PPML-Group/LiberGripper_V1/README.md

# LiberGripper_V1
A compact, single–degree-of-freedom **parallel gripper** driven by a **DM4310** actuator. **Purpose-built for robotic manipulation and grasping tasks.**  
Two interchangeable end-effector variants are provided:

- **Finned adaptive fingers** — compliant, underactuated “fin-ray” style fingers that conform to objects of varying shapes.
- **Rigid parallel fingers** — simple, stiff pads for precise, repeatable clamping.

<!-- ![Finned adaptive gripper](Picture/LiberGripper_Fin-ray.png)
![Rigid parallel gripper](Picture/LiberGripper_normal.png) -->
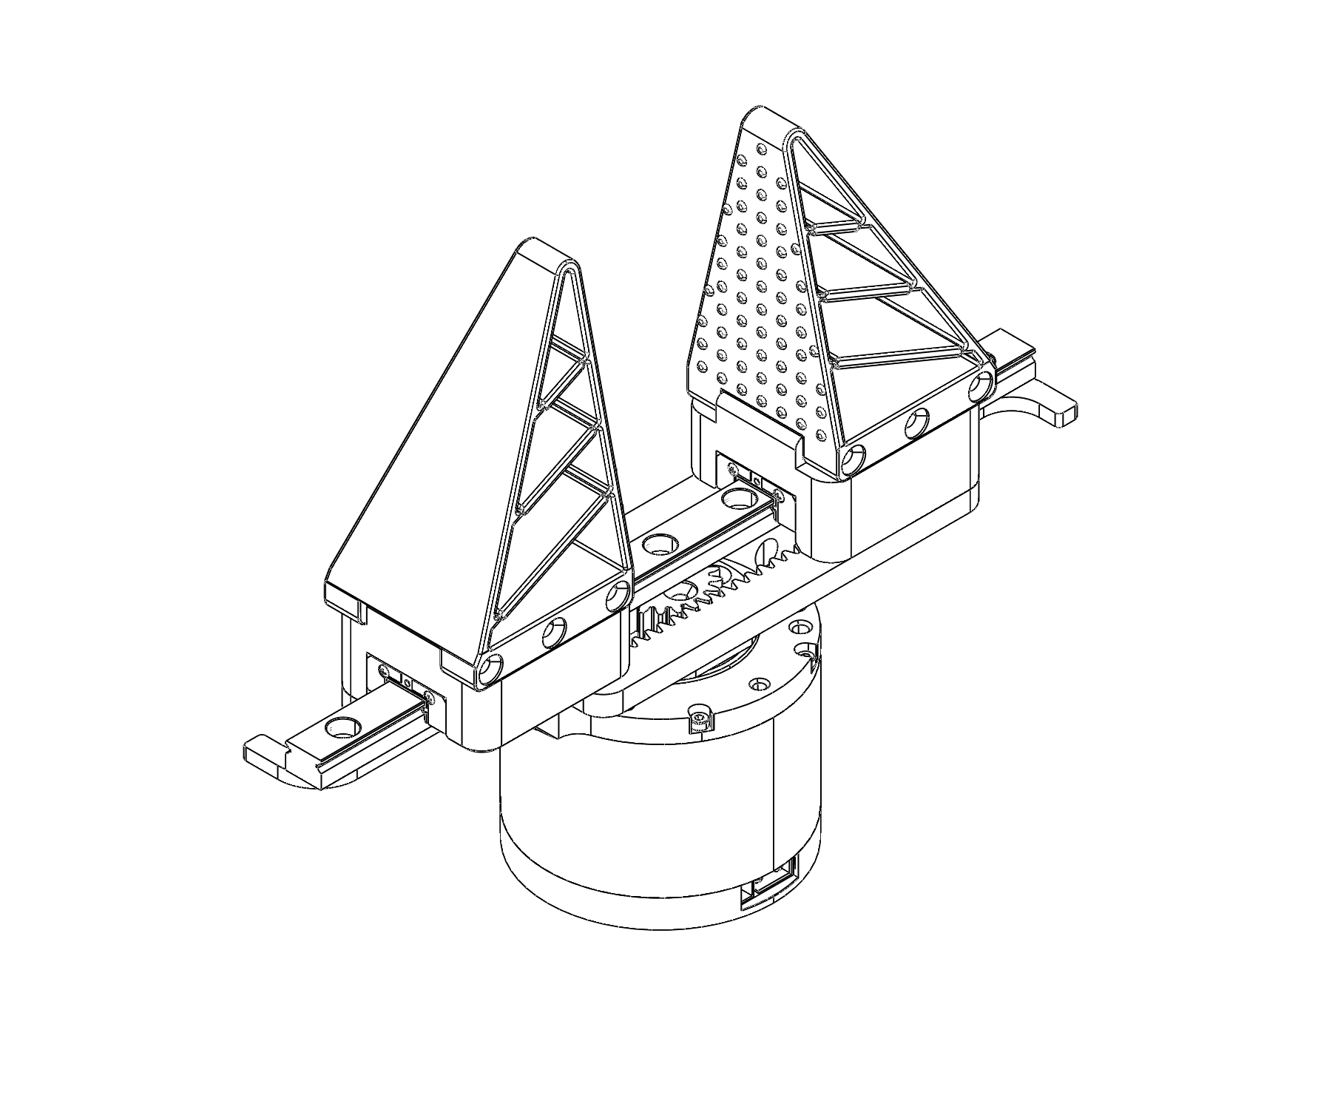
[picture p1: Picture/LiberGripper_Fin-ray.png]
Finned adaptive gripper

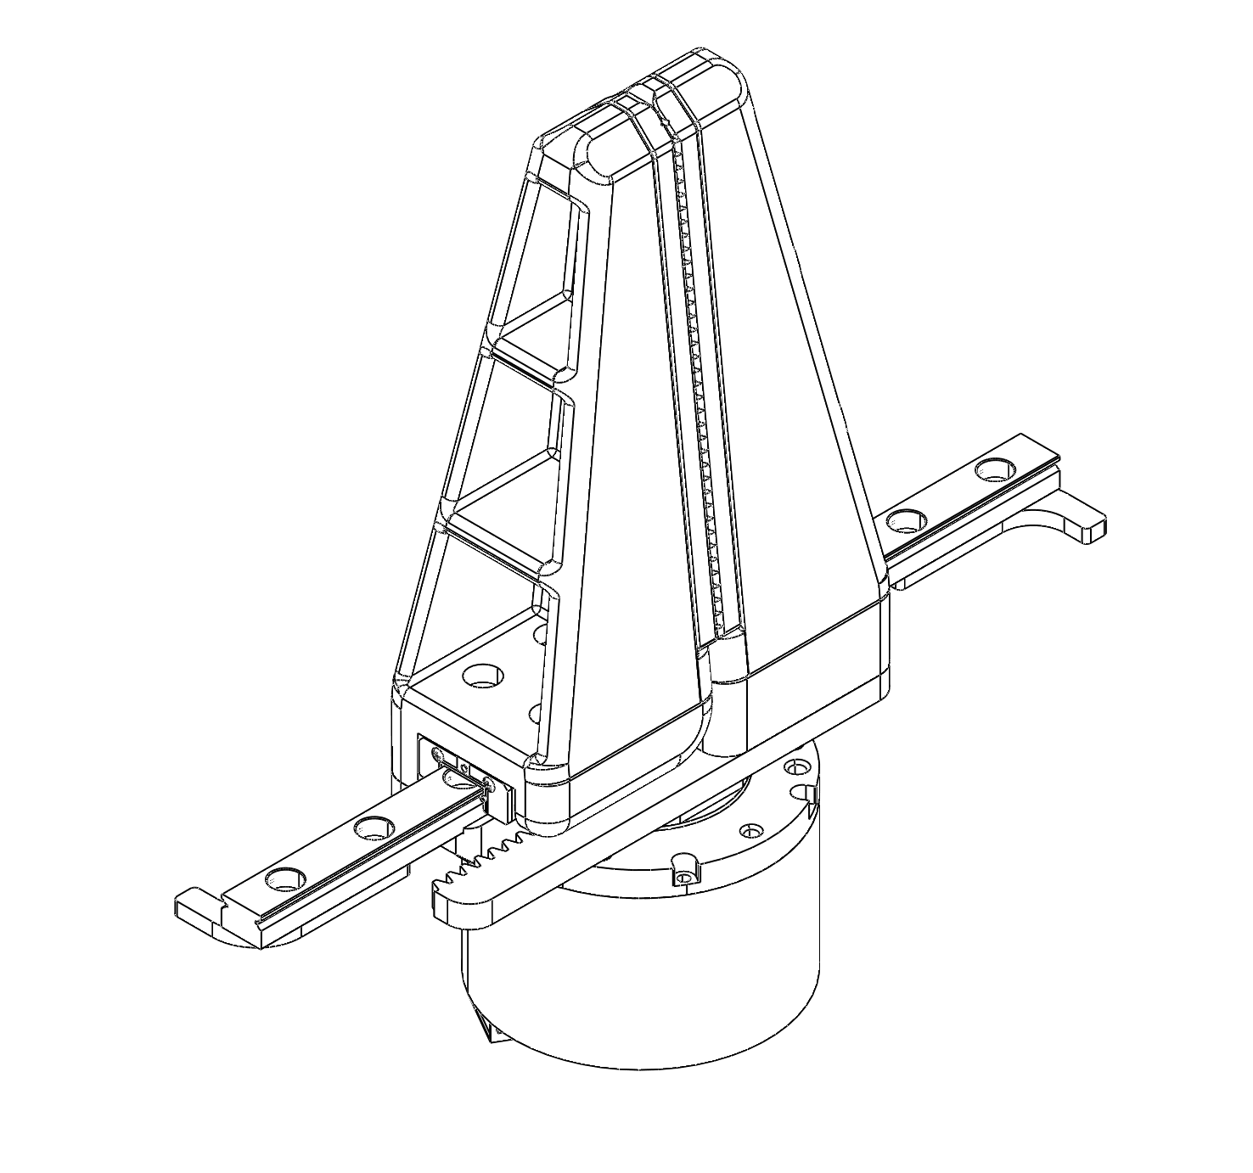
[picture p2: Picture/LiberGripper_normal.png]
Rigid gripper


<small>You can also download the 3D model here: <a href="https://grabcad.com/library/two-finger-gripper-2">GrabCAD – Two-Finger Gripper</a></small>

## Acknowledgments

Developed by Liberty Robotics – PPML-G (Perception, Planning, Manipulation & Locomotion Group).
