PPML-Group/LiberGripper_V1/Machining/圆柱齿轮20齿1模.STEP

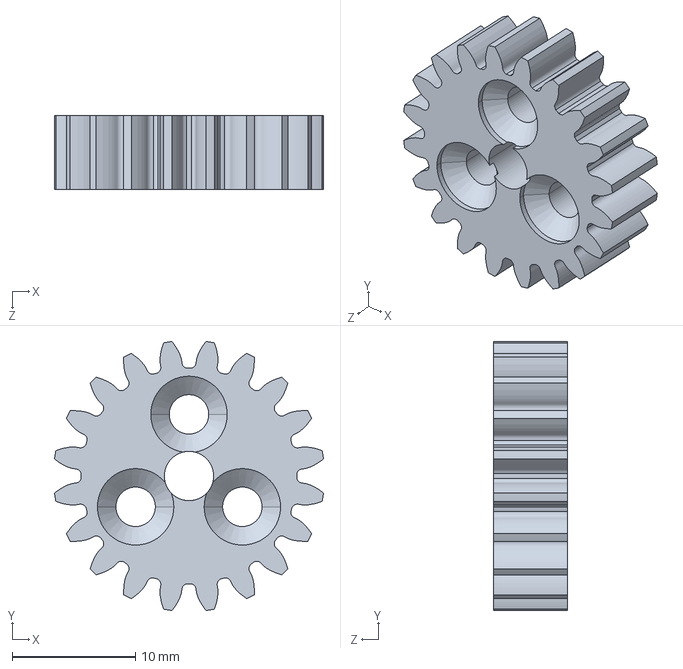
[picture p4: CAD file, 2025-10-26]
Machining/圆柱齿轮20齿1模.STEP
21.8 x 21.8 x 6.00 mm
