PPML-Group/LiberGripper_V1/Machining/夹爪限位.STEP

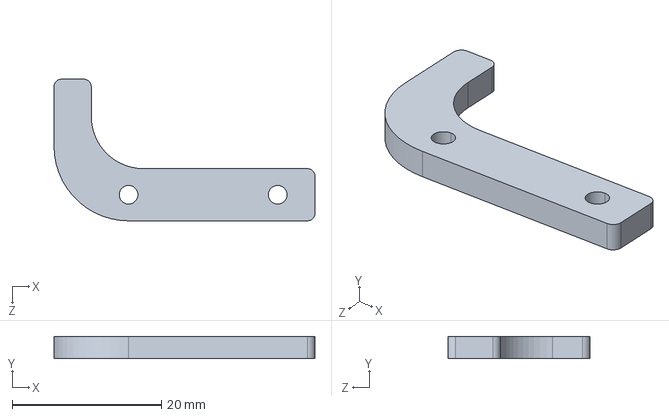
[picture p5: CAD file, 2025-10-26]
Machining/夹爪限位.STEP
35.0 x 3.00 x 19.0 mm
