PPML-Group/LiberGripper_V1/Machining/夹爪连接件.STEP

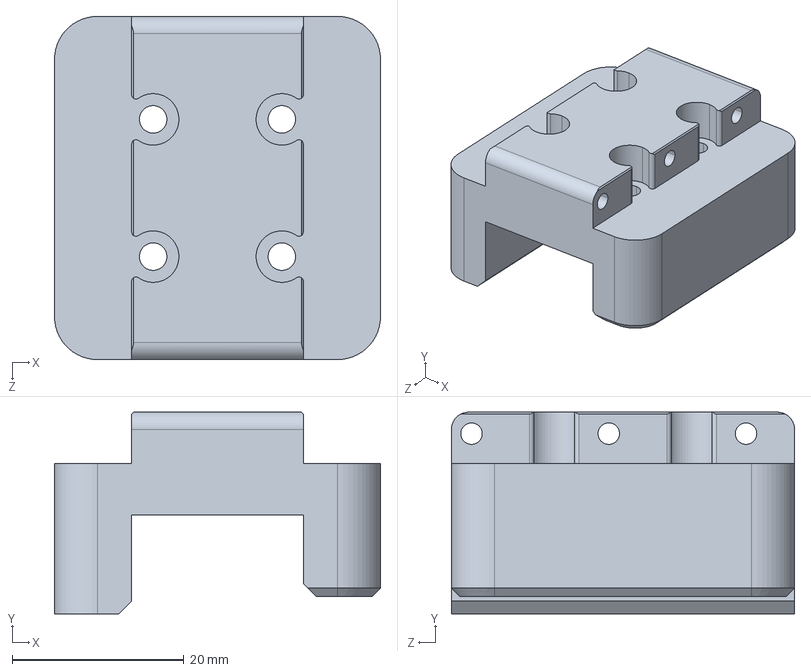
[picture p6: CAD file, 2025-10-26]
Machining/夹爪连接件.STEP
38.0 x 23.5 x 40.0 mm
