PPML-Group/LiberGripper_V1/Machining/快拆座替换驱动板盖.STEP

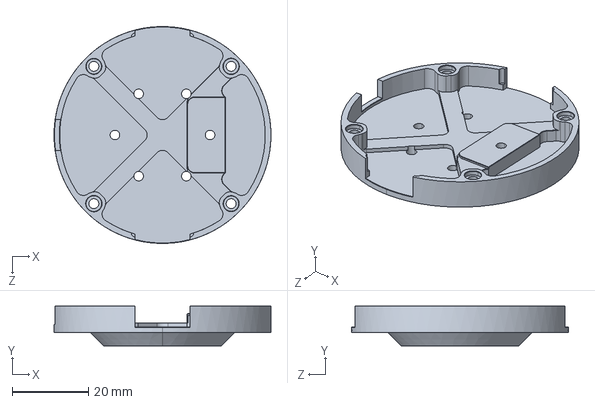
[picture p7: CAD file, 2025-10-26]
Machining/快拆座替换驱动板盖.STEP
57.0 x 10.5 x 57.0 mm
