PPML-Group/LiberGripper_V1/Machining/导轨座含电机前盖.STEP

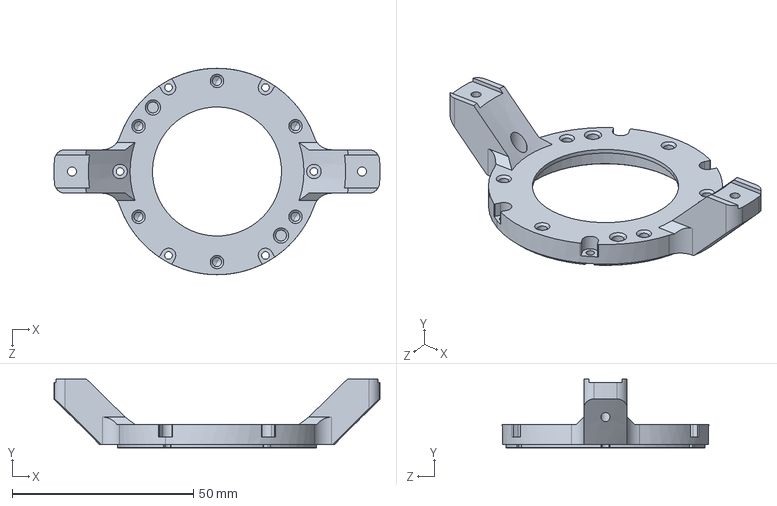
[picture p8: CAD file, 2025-10-26]
Machining/导轨座含电机前盖.STEP
90.0 x 19.0 x 57.0 mm
