PPML-Group/LiberGripper_V1/Machining/夹爪齿条1模.STEP

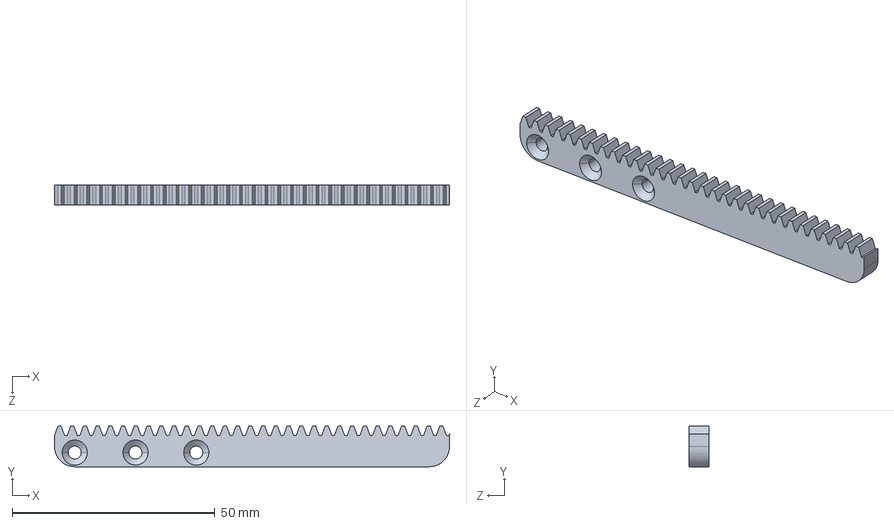
[picture p9: CAD file, 2025-10-26]
Machining/夹爪齿条1模.STEP
97.5 x 10.0 x 5.00 mm
