PPML-Group/LiberGripper_V1/Machining/圆柱齿轮20齿1模.pdf

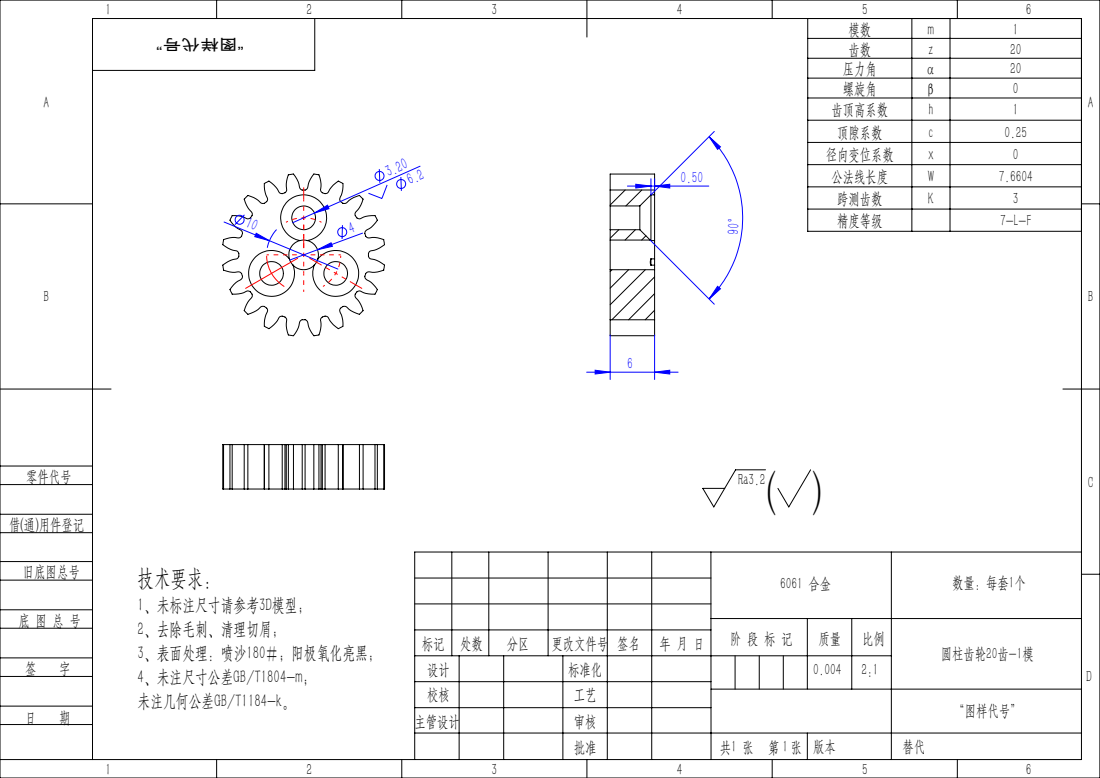
[picture p10: page 1]

模数 | m | 1
齿数 | z | 20
压力角 | α | 20
螺旋角 | β | 0
齿顶高系数 | h | 1
顶隙系数 | c | 0.25
径向变位系数 | x | 0
公法线长度 | W | 7.6604
跨测齿数 | K | 3
精度等级 | | 7-L-F

阶 段 标 记 | 质量 | 比例 | 圆柱齿轮20齿-1模

标记 | 处数 | 分区 | 更改文件号 | 签名 | 年 月 日

“图样代号”
