PPML-Group/LiberGripper_V1/Machining/夹爪连接件.pdf

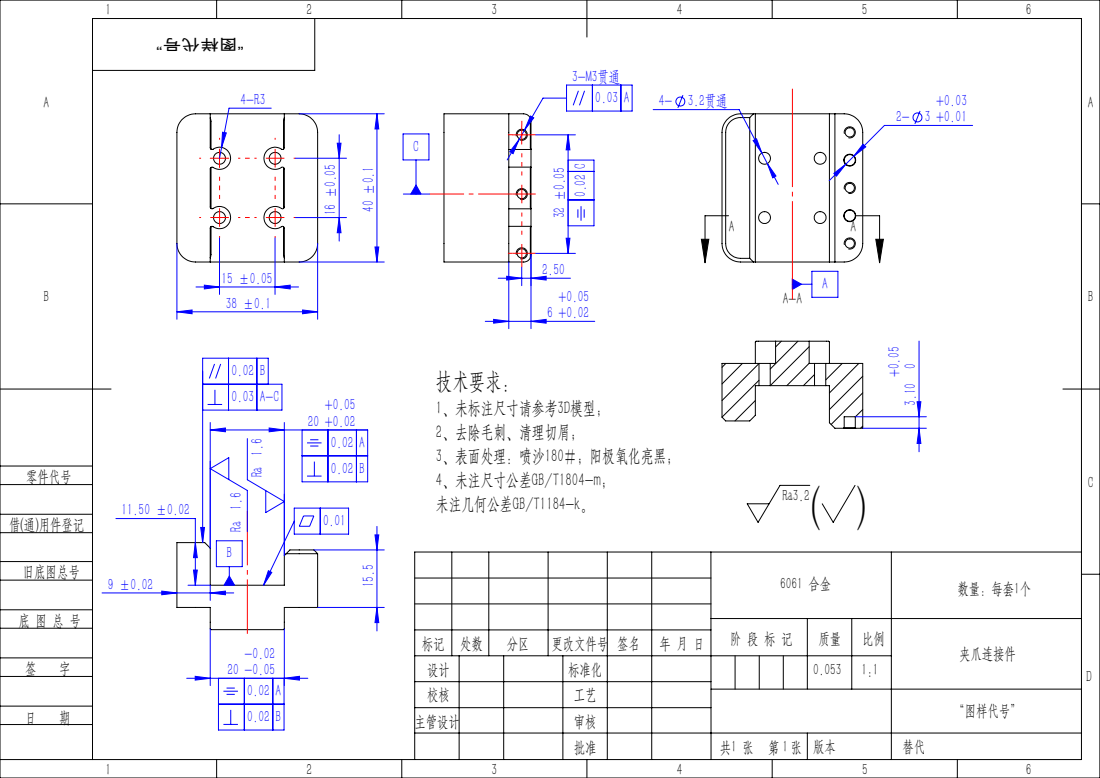
[picture p11: page 1]

阶 段 标 记 | 质量 | 比例 | 夹爪连接件

标记 | 处数 | 分区 | 更改文件号 | 签名 | 年 月 日

“图样代号”
