PPML-Group/LiberGripper_V1/Machining/夹爪限位.pdf

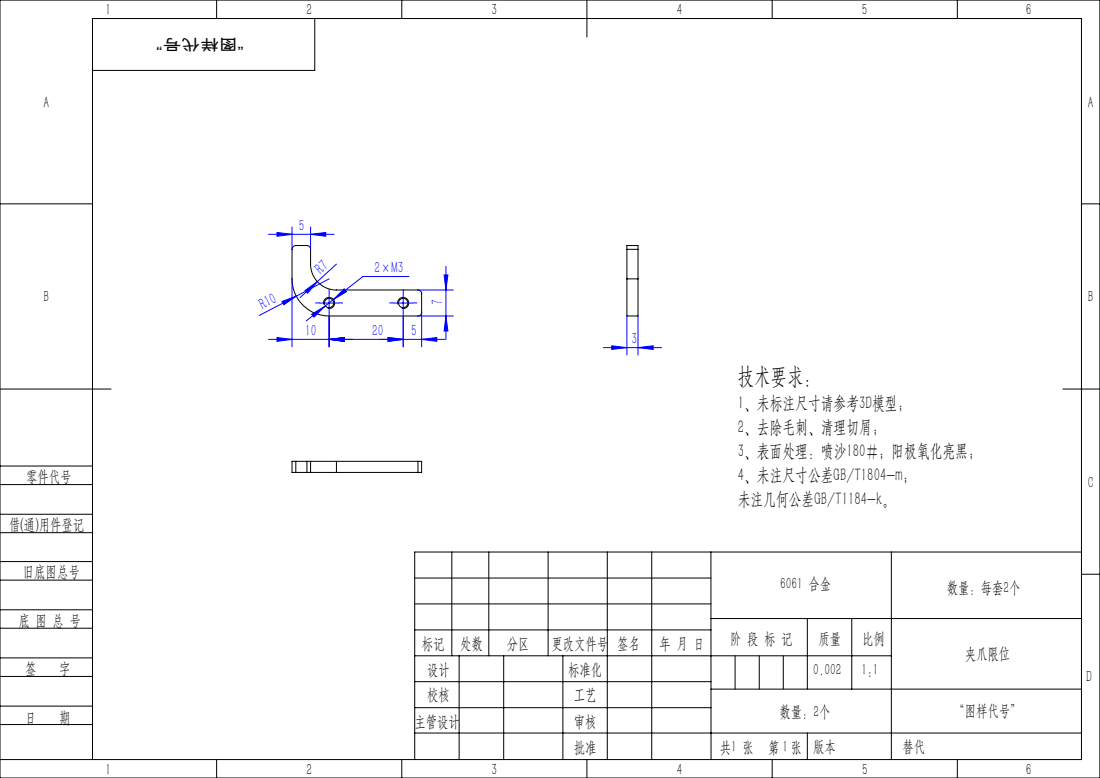
[picture p12: page 1]

阶 段 标 记 | 质量 | 比例 | 夹爪限位

标记 | 处数 | 分区 | 更改文件号 | 签名 | 年 月 日

数量：2个 | “图样代号”
