PPML-Group/LiberGripper_V1/Machining/导轨座含电机前盖.pdf

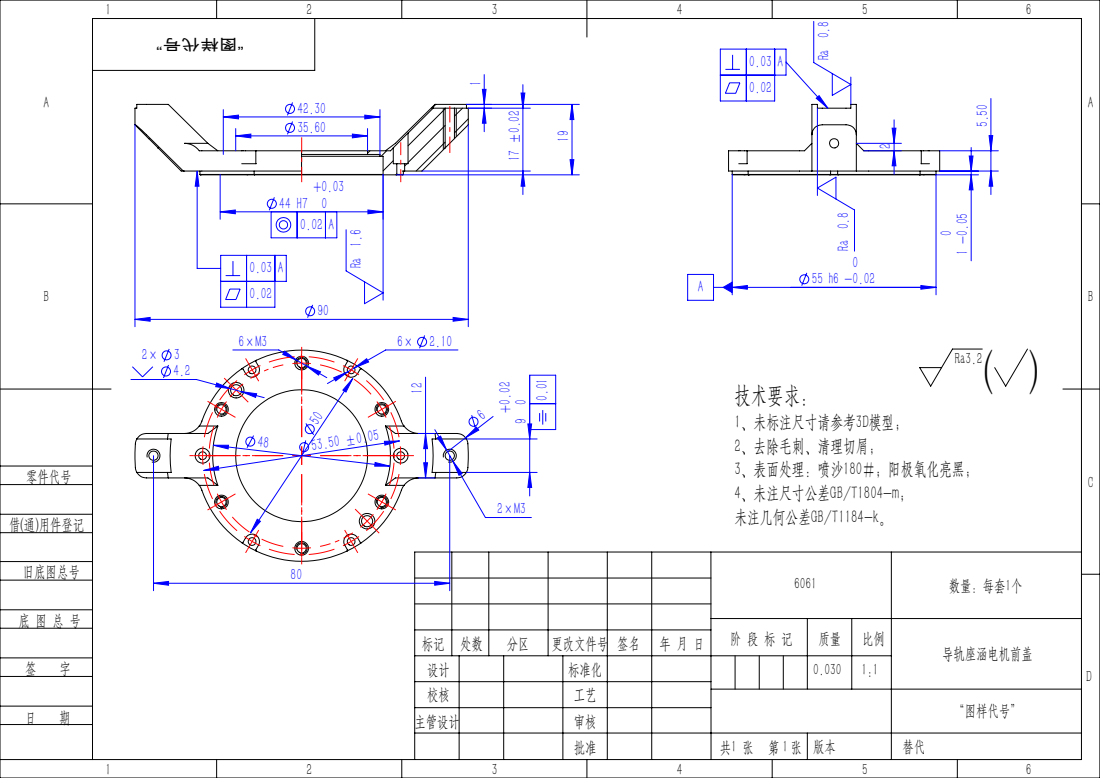
[picture p15: page 1]

0.03 | A
0.02

阶 段 标 记 | 质量 | 比例 | 导轨座涵电机前盖

标记 | 处数 | 分区 | 更改文件号 | 签名 | 年 月 日

“图样代号”
