PPML-Group/LiberGripper_V1/Machining/快拆座替换驱动板盖.pdf

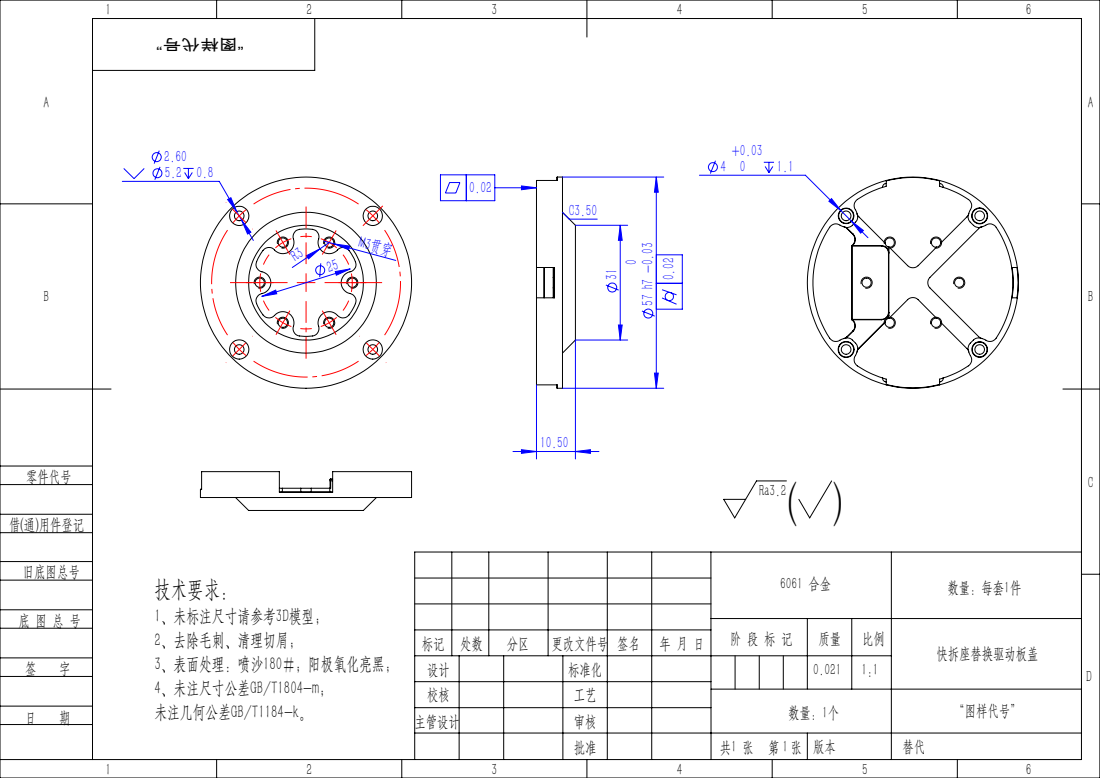
[picture p16: page 1]

阶 段 标 记 | 质量 | 比例 | 快拆座替换驱动板盖

标记 | 处数 | 分区 | 更改文件号 | 签名 | 年 月 日

数量：1个 | “图样代号”
